YuanchenZhang2002/Smart-Accelerator-Control/Core/Inc/main.h

#define B1_Pin GPIO_PIN_13
#define B1_GPIO_Port GPIOC
#define B1_EXTI_IRQn EXTI15_10_IRQn
#define CALIBRATION_Pin GPIO_PIN_1
#define CALIBRATION_GPIO_Port GPIOA
#define CALIBRATION_EXTI_IRQn EXTI1_IRQn
#define USART_TX_Pin GPIO_PIN_2
#define USART_TX_GPIO_Port GPIOA
#define USART_RX_Pin GPIO_PIN_3
#define USART_RX_GPIO_Port GPIOA
#define BRAKE_Pin GPIO_PIN_7
#define BRAKE_GPIO_Port GPIOA
#define TMS_Pin GPIO_PIN_13
#define TMS_GPIO_Port GPIOA
#define TCK_Pin GPIO_PIN_14
#define TCK_GPIO_Port GPIOA
#define SWO_Pin GPIO_PIN_3
#define SWO_GPIO_Port GPIOB
#define RELAY_CTRL_Pin GPIO_PIN_5
#define RELAY_CTRL_GPIO_Port GPIOB
#define CALIBRATION_ADDR     0x080FF800  // Page 511
#define CALIBRATION_MAGIC    0x55AA55AA
#define RING_ADC_MIN 1170  
#define RING_ADC_MAX 2810  
#define ADC_OUT_OF_RANGE_MIN 100
#define ADC_OUT_OF_RANGE_MAX  4045
#define RATIONALITY_TOLERANCE 100
#define RING_ENTRY_THRESHOLD  150
#define RING_EXIT_THRESHOLD   50
