YuanchenZhang2002/Smart-Accelerator-Control/(commit log)

2026-06-29 Initial commit: STM32 Project Submission for Supervisor Review
2026-07-01 feat: implement ADC configuration and initial system state logic for ring accelerator
2026-07-02 feat: implement core ring accelerator logic including ADC filtering, state machine transitions, and flash calibration storage
2026-07-03 feat: implement core ring accelerator logic with state machine, ADC filtering, and flash-based calibration support
2026-07-07 feat: implement main application loop, ADC processing, brake monitoring, and system state transition logic
2026-07-07 feat: implement system state machine for ring accelerator control, including calibration, pedal plausibility, and relay management logic
2026-07-09 feat: implement system state machine and calibration logic for ring accelerator control
2026-07-16 feat: implement ADC data processing, state machine integration, and flash calibration storage in main loop
2026-08-19 feat: implement system state machine for pedal sensor calibration and ring acceleration control
2026-09-15 Add README.md for Smart Accelerator Control project
    Added detailed project documentation for the Smart Accelerator Control system, including features, architecture, hardware prototype, firmware design, and testing results.
